julpage/beggar_socket/SCH_Schematic6_1_2025-04-16.pdf

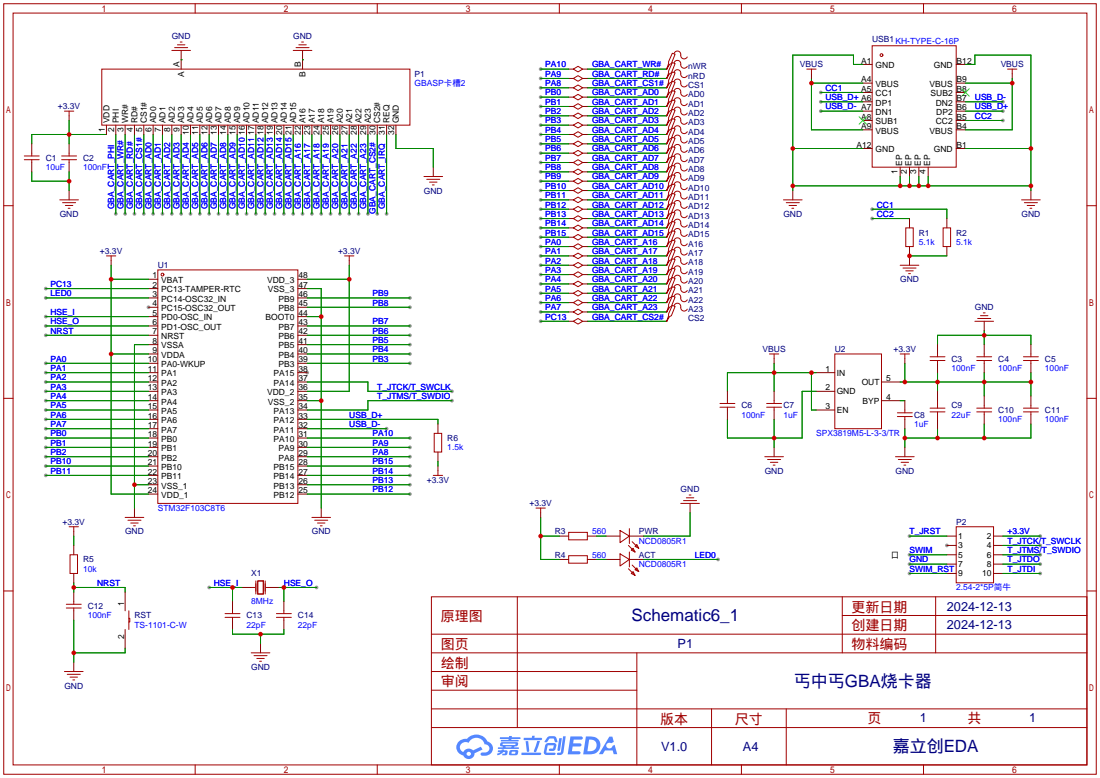
[picture p1: page 1]
