julpage/beggar_socket/mcu/chis_flash_burner/chis_flash_burner.ioc

Mcu.UserName=STM32F103C8Tx
PA0-WKUP.GPIO_Label=a16
PA0-WKUP.Signal=GPIO_Input
PA1.GPIO_Label=a17
PA1.Signal=GPIO_Input
PA10.GPIO_Label=wr
PA10.Signal=GPIO_Output
PA11.Signal=USB_DM
PA12.Signal=USB_DP
PA13.Signal=SYS_JTMS-SWDIO
PA14.Signal=SYS_JTCK-SWCLK
PA2.GPIO_Label=a18
PA2.Signal=GPIO_Input
PA3.GPIO_Label=a19
PA3.Signal=GPIO_Input
PA4.GPIO_Label=a20
PA4.Signal=GPIO_Input
PA5.GPIO_Label=a21
PA5.Signal=GPIO_Input
PA6.GPIO_Label=a22
PA6.Signal=GPIO_Input
PA7.GPIO_Label=a23
PA7.Signal=GPIO_Input
PA8.GPIO_Label=cs1
PA8.Signal=GPIO_Output
PA9.GPIO_Label=rd
PA9.Signal=GPIO_Output
PB0.GPIO_Label=ad0
PB0.Signal=GPIO_Input
PB1.GPIO_Label=ad1
PB1.Signal=GPIO_Input
PB10.GPIO_Label=ad10
PB10.Signal=GPIO_Input
PB11.GPIO_Label=ad11
PB11.Signal=GPIO_Input
PB12.GPIO_Label=ad12
PB12.Signal=GPIO_Input
PB13.GPIO_Label=ad13
PB13.Signal=GPIO_Input
PB14.GPIO_Label=ad14
PB14.Signal=GPIO_Input
PB15.GPIO_Label=ad15
PB15.Signal=GPIO_Input
PB2.GPIO_Label=ad2
PB2.Signal=GPIO_Input
PB3.GPIO_Label=ad3
PB3.Signal=GPIO_Input
PB4.GPIO_Label=ad4
PB4.Signal=GPIO_Input
PB5.GPIO_Label=ad5
PB5.Signal=GPIO_Input
PB6.GPIO_Label=ad6
PB6.Signal=GPIO_Input
PB7.GPIO_Label=ad7
PB7.Signal=GPIO_Input
PB8.GPIO_Label=ad8
PB8.Signal=GPIO_Input
PB9.GPIO_Label=ad9
PB9.Signal=GPIO_Input
PC13-TAMPER-RTC.GPIO_Label=cs2
PC13-TAMPER-RTC.Signal=GPIO_Output
PC14-OSC32_IN.GPIO_Label=led
PC14-OSC32_IN.Signal=GPIO_Output
PD0-OSC_IN.Signal=RCC_OSC_IN
PD1-OSC_OUT.Signal=RCC_OSC_OUT
