julpage/beggar_socket/(commit log)

2025-06-11 支持gba合卡
2025-07-21 修复gba rom文件大小非2的整数倍时最后一个字节会被忽略的问题
2025-07-22 支持leondiy的mbc卡
2025-08-15 解锁ppb，修改时间，震动测试，适配fram，免电存档
2025-11-01 加入mbc3功能。 全片擦除会预估个进度。 为碳酸丐适配个5V输出。
2025-11-02 优化RTC判断逻辑
2025-11-04 优化skyemu读取响应速度
2025-11-05 再次优化RTC判断逻辑
2025-11-08 修复因mbc5页改名导致读id无效的bug
2026-01-07 修bug
